sethmo2/sp25_ece445_lab_notebook/kicad/BackTracker.kicad_pcb

## KiCad design kicad/BackTracker.kicad_pcb (2025-03-25)

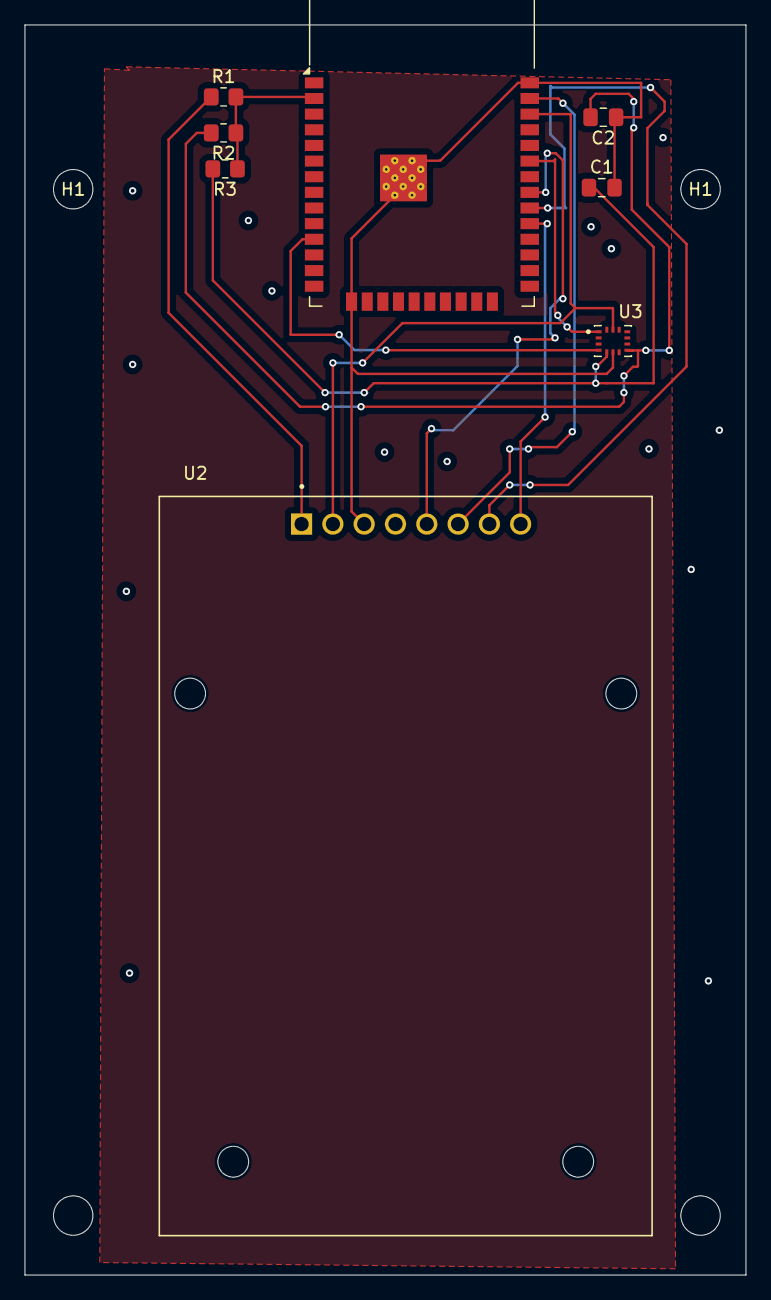
[picture p9: board BackTracker.kicad_pcb from above]

Board: 2 copper layers, 58.5 x 101.5 mm, 12 parts (0 on the bottom side), 12 nets.

Parts:
C1, C2: 0.1uF; C_0805_2012Metric_Pad1.18x1.45mm_HandSolder
H1, H1#2, H4, H4#2: MountingHole; MountingHole_3.2mm_M3
R1: 200; R_0805_2012Metric_Pad1.20x1.40mm_HandSolder
R2, R3: 10k; R_0805_2012Metric_Pad1.20x1.40mm_HandSolder
U1: ESP32-WROOM-32D
U2: CEG006900; MODULE_CEG006900
U3: ICM-45605; XDCR_ICM-45605

Connections:
+3.3V: R1.2, R2.1, R3.1, U1.2 (VDD)
GND: C1.2, C2.1, U1.1 (GND), U1.15 (GND), U1.38 (GND), U1.39 (GND), U2.3 (GND), U3.6 (GND)
unnamed: U1.29 (IO5), U2.8 (SS/SDA/RX)
unnamed: U1.30 (IO18), U2.7 (SCK)
unnamed: U1.31 (IO19), U2.5 (MISO/SCL/TX)
unnamed: U1.33 (IO21), U3.1 (AP_SDO/AP_AD0), U3.14 (AP_SDA/AP_SDIO/AP_SDI)
unnamed: U1.36 (IO22), U2.2 (RST), U3.13 (AP_SCL/AP_SCLK)
unnamed: U1.37 (IO23), U2.6 (MOSI)
unnamed: U1.11 (IO26), U3.4 (INT1/INT)
unnamed: R1.1, U2.1 (VCC)
unnamed: C2.2, R2.2, U3.8 (VDD)
unnamed: C1.1, R3.2, U3.5 (VDDIO)
