sethmo2/sp25_ece445_lab_notebook/(commit log)

2025-03-10 Added ESP32 code
2025-03-25 Updated kicad files, fixed some errors
    [BackTracker-B_Cu.gbr, BackTracker-B_Mask.gbr, BackTracker-B_Paste.gbr, BackTracker-B_Silkscreen.gbr, BackTracker-Edge_Cuts.gbr, BackTracker-F_Cu.gbr, BackTracker-F_Mask.gbr, BackTracker-F_Paste.gbr]
2025-04-03 Added KiCad files for PCB
2025-04-14 Updated KiCad .zip file
2025-04-22 Added motor attempt code
2025-04-22 Adding IMU Motor Logic code
